ericmaclean/Pedal-Isolated-Power-Supply/README.md

# Pedal-Isolated-Power-Supply

This is a project folder for a 9 channel isolated power supply. The design is based around the WPDL transformer that steps down 120VAC to 9VAC with 9 separate secondary windings. The isolated secondary windings ensure there are no ground loops contributing to common mode noise. The AC waveform is rectified and and then filtered and passed to a linear regulator which regulates the output at 9VDC. Each DC output is capable of outputting a continuous 200-300mA. One channel has a current limited LED which features as a power indication light. A 180V MOV on the primary side of the transformer as well as a 19V TVS diode serve as surge protection, while a fast blow 10A fuse on the primary serves as short circuit current protection.

## Features: 

- 9 channel 9VDC 200mA true isolated power 
- Full bridge rectification and filtering 
- MOV and TVS surge protection
- EMI filtering
- Fast blow 10A primary fuse and PTC 300mA secondary fuse
- Power switch and LED for power indication

## Functional Circuit Diagram 
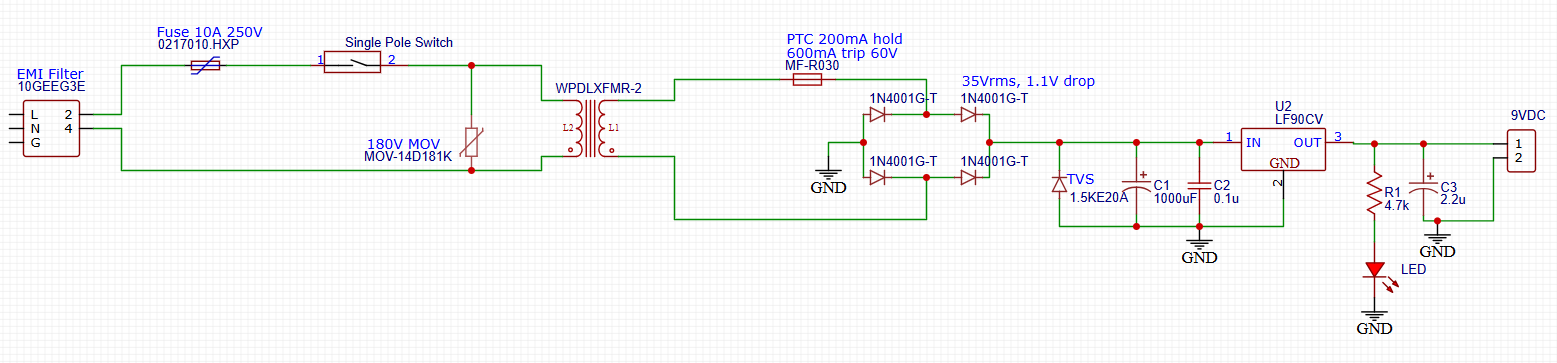
[picture p1: ScreenShots/FunctionalBlockDiagram .png]


It's important to know when sizing components that a linear power supply holds the peak voltage of the voltage input which creates the DC level voltage. The 120VAC to 9VAC transformer is an RMS rating and needs to be converted to peak voltage, the voltage seen by the secondary winding is 12.72V (Vpeak = Vrms * sqrt(2)). The full bridge rectifier causes both the positive and negative cycles to experience 2 diode drops before reaching the capacitor, the capacitor holds this peak of 10.5V (12.72 - 2 * Vf) which is then regulated down to 9V by a votlage regulator. Linear voltage regulators have losses dissapated as heat related to the difference between the supply voltage, the regulated voltage, and load current (Watts = (10.5V-9.5V) * Iload).  

## Falstad Current Flow 
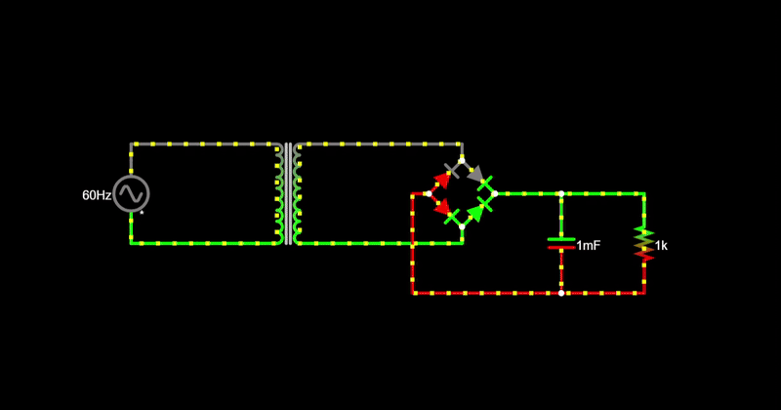
[picture p2: ScreenShots/Falstad60hztoDCfullbridgerectifier-ezgif.com-video-to-gif-converter.gif]

alternative text

Visualizing the current we are able to see the current source spiking to charge the capacitor every cycle. This reveals a poor power factor inherent to linear power supplies, poor power factor results in a larger than necessary current flowing through components that aren't contributing to the load power. Current contributes to I^2R heating losses and lead to wear on the transformer, diodes, and capacitors in this circuit. Current spikes can generate odd harmonics that propagate down power lines and cause EMI on neighboring circuits. This can be mitigated with EMI filtering on the power source and adding an inductive choke which resists sharp changes in current, however smoothing the current spikes will result in lower voltage peaks seen by the capacitor reducing the effective DC voltage on the output. Raising the capacitance will reduce the amount of ripple seen by the load, however a larger capacitance will increase the peak supply current needed to charge the capacitor.

- You can simulate and modify this circuit in Falstad by going here https://www.falstad.com/
- And opening this text file https://github.com/ericmaclean/Pedal-Isolated-Power-Supply/blob/main/falstad/Falstad_LinearRectifier.txt
## LTspice Simulation
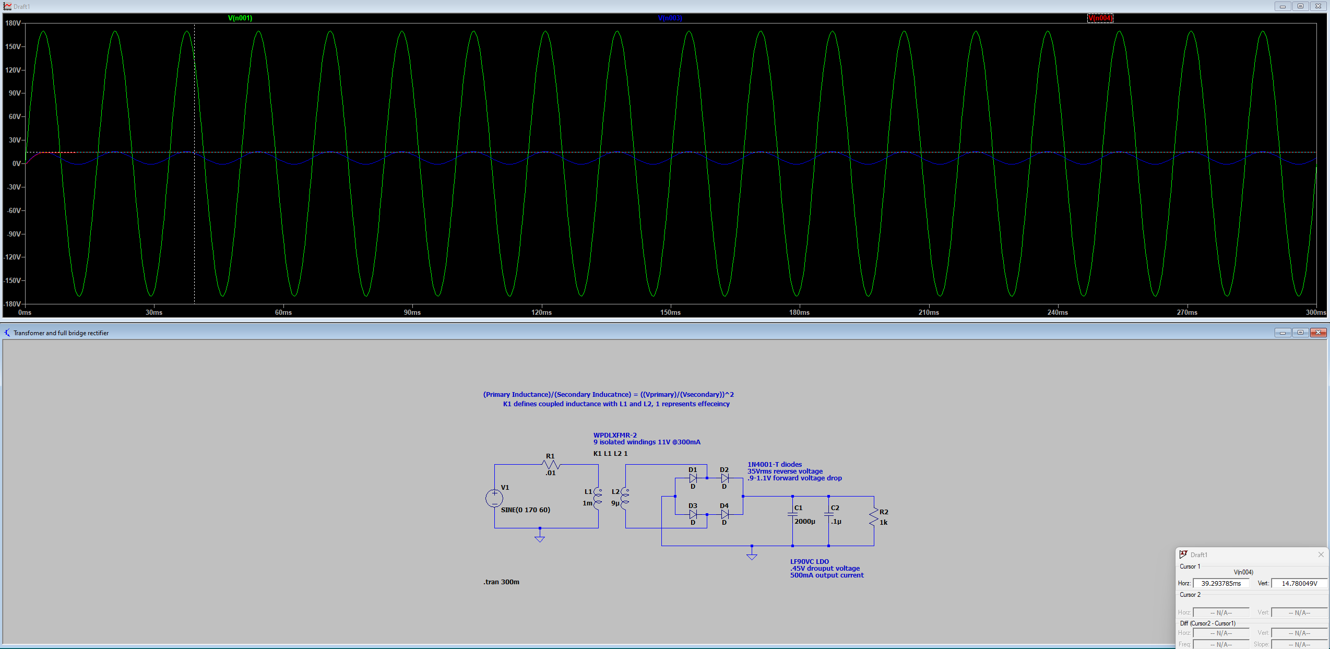
[picture p3: ScreenShots/SpiceSC.png]

## EasyEDA layout and Gerber Files
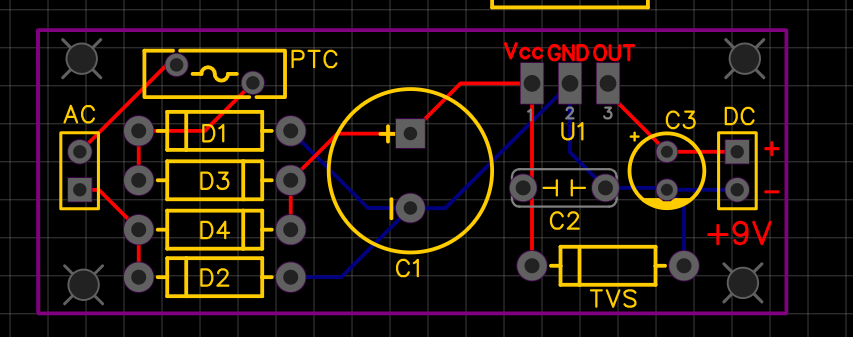
[picture p4: ScreenShots/EasyEDA_Layout.png]


I ordered 10 boards each of which act as a separate channel, ordering the boards individually made the order cheaper and simpler than having one board for everything. On a second revision I would consider making the through holes on the TVS diode larger, the 1.5KE20A TVS diode is rated for a 54A peak current and has much larger leads than I anticiapted.

## Build 
alternative text
alternative text

## Bill of Materials 
I bought all the electronics on mouser but found the enclosures and jacks are much cheaper on Ali Express
- Go here for a complete bill of materials in an excel file https://github.com/ericmaclean/Pedal-Isolated-Power-Supply/blob/main/Power%20supply.xlsx
