ericmaclean/Pedal-Isolated-Power-Supply/ScreenShots/EasyEDA_Schematic.png

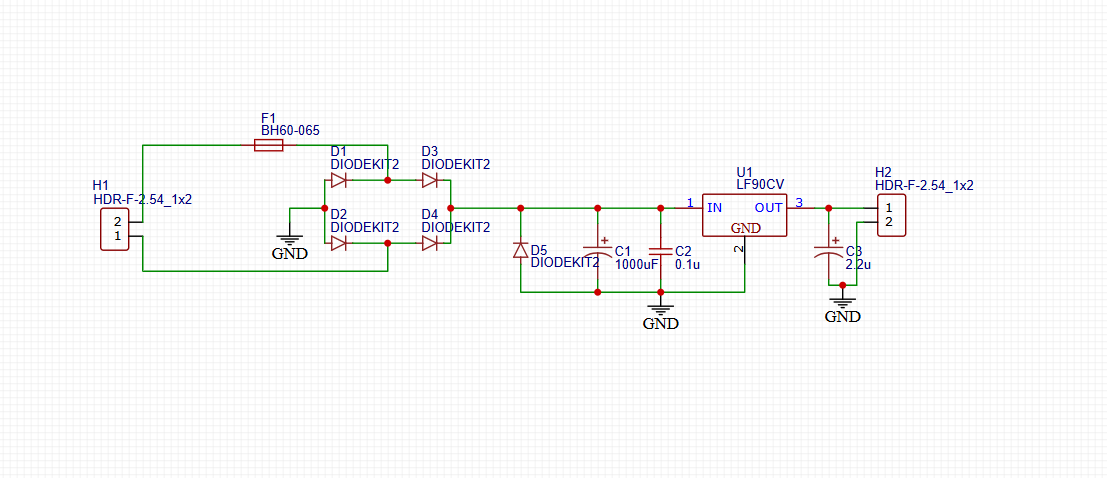
ScreenShots/EasyEDA_Schematic.png
