ericmaclean/Pedal-Isolated-Power-Supply/ScreenShots/WPDLXXFMR-2.png

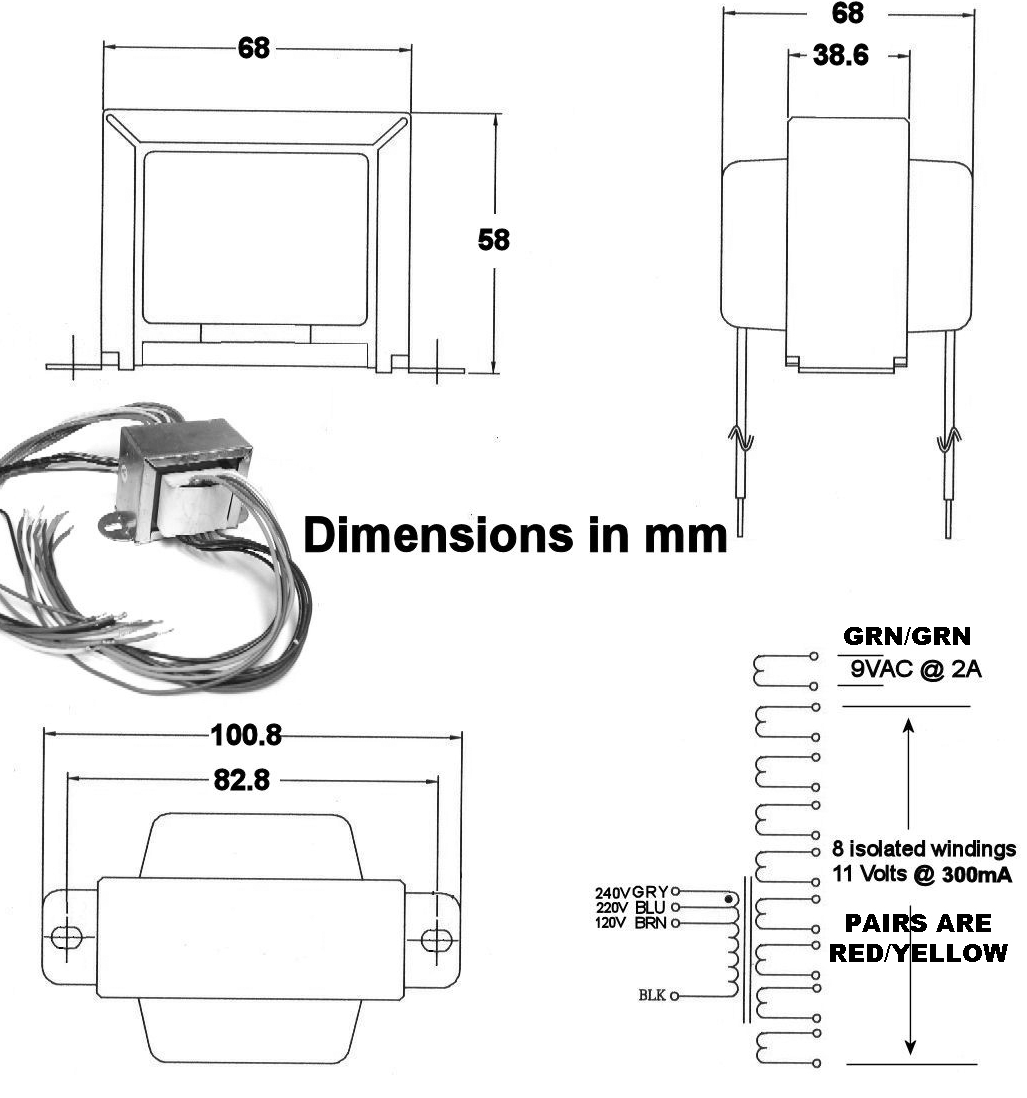
ScreenShots/WPDLXXFMR-2.png
