ericmaclean/Pedal-Isolated-Power-Supply/LTspice/Transfomer and full bridge rectifier.asc

C1: cap; 2000µ
C2: cap; .1µ
D1: diode
D2: diode
D3: diode
D4: diode
L1: ind2; 1m
L2: ind2; 9µ
R1: res; .01
R2: res; 1k
V1: voltage; SINE(0 170 60)
Named nets: 0
K1 L1 L2 1
WPDLXFMR-2
9 isolated windings 11V @300mA
(Primary Inductance)/(Secondary Inducatnce) = ((Vprimary)/(Vsecondary))^2
K1 defines coupled inductance with L1 and L2, 1 represents effeceincy
1N4001-T diodes
35Vrms reverse voltage
.9-1.1V forward voltage drop
LF90VC LDO
.45V drouput voltage
500mA output current
.tran 300m
